lab11/embedded-gw/hardware/rev_c/embedded-gw_pcb.png

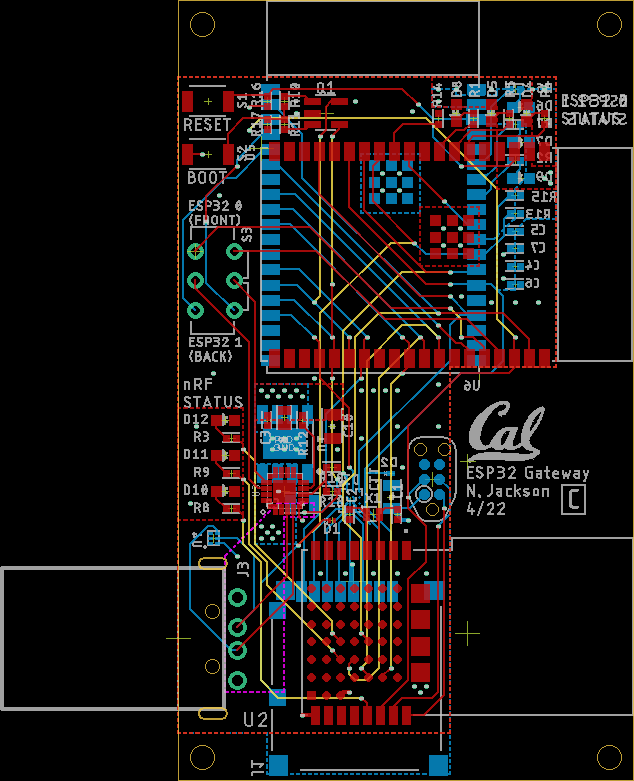
hardware/rev_c/embedded-gw_pcb.png
