lab11/embedded-gw/case/Case.stl

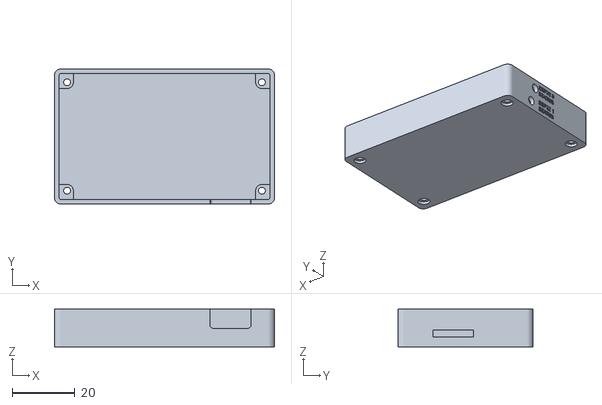
[picture p2: CAD file, 2022-06-08]
case/Case.stl
70.0 x 43.0 x 12.0
