lab11/embedded-gw/case/Top.stl

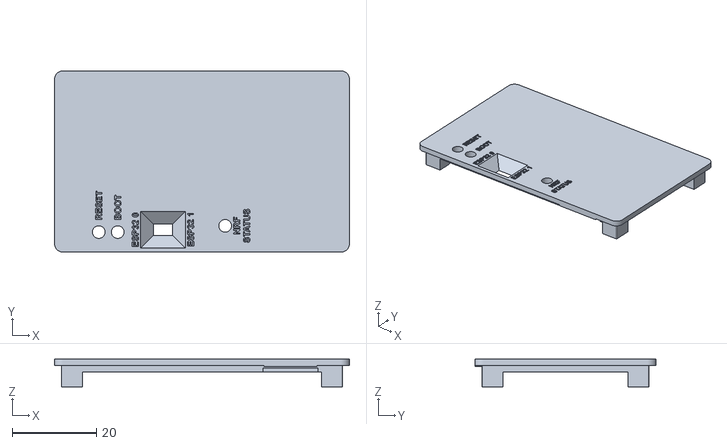
[picture p3: CAD file, 2022-06-08]
case/Top.stl
70.0 x 43.0 x 6.57
