lab11/embedded-gw/case/embedded_gw_enclosure v12.step

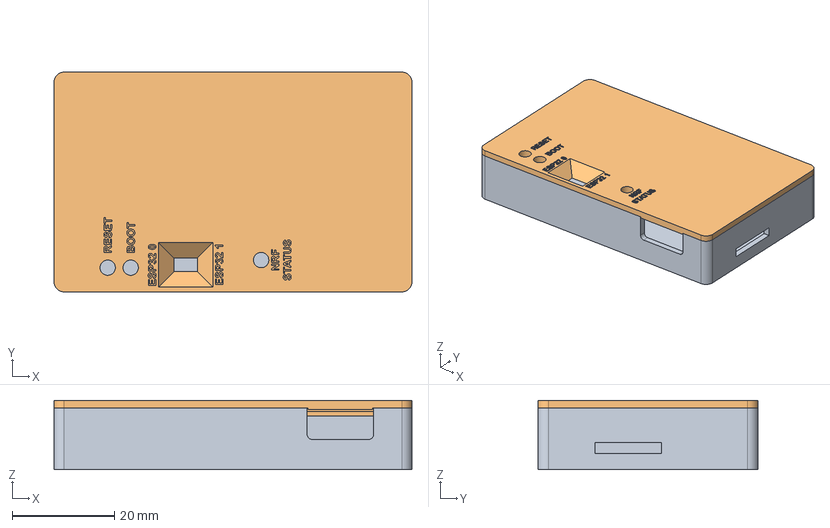
[picture p4: CAD file, 2022-06-08]
case/embedded_gw_enclosure v12.step
70.0 x 43.0 x 13.5 mm
Case
Top
