lab11/embedded-gw/(list of files, cad)

Other CAD files:
case/embedded_gw_enclosure v12.f3z
