lab11/embedded-gw/hardware/rev_c/embedded-gw.pdf

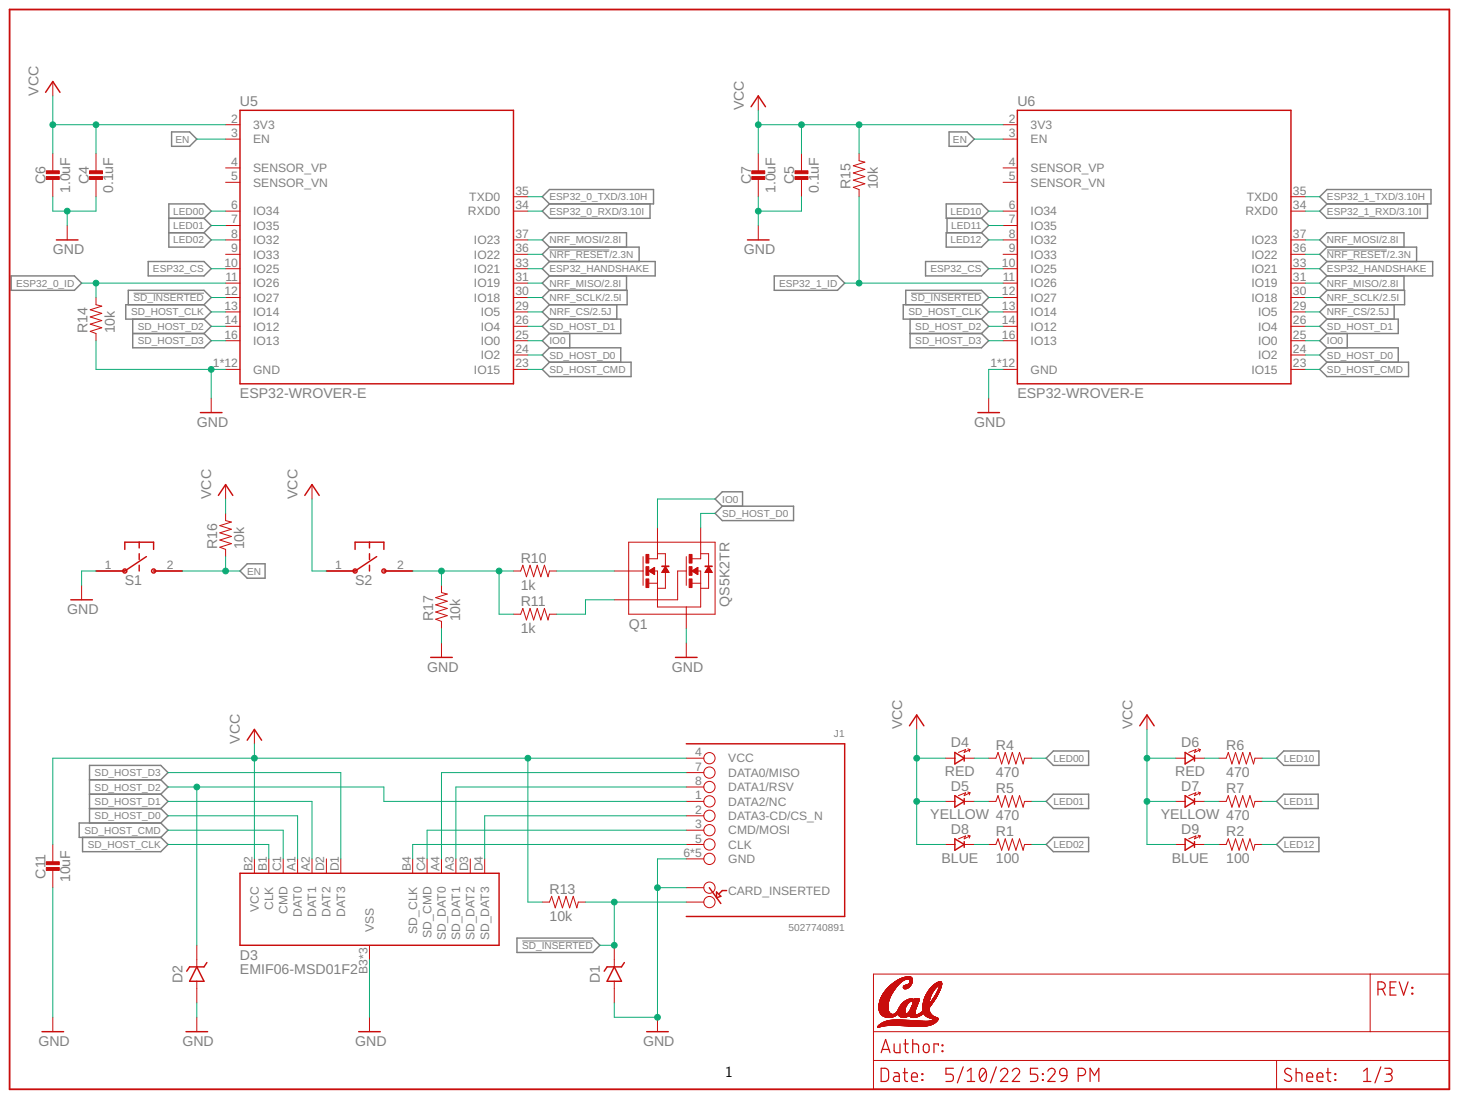
[picture p5: page 1]

6*5

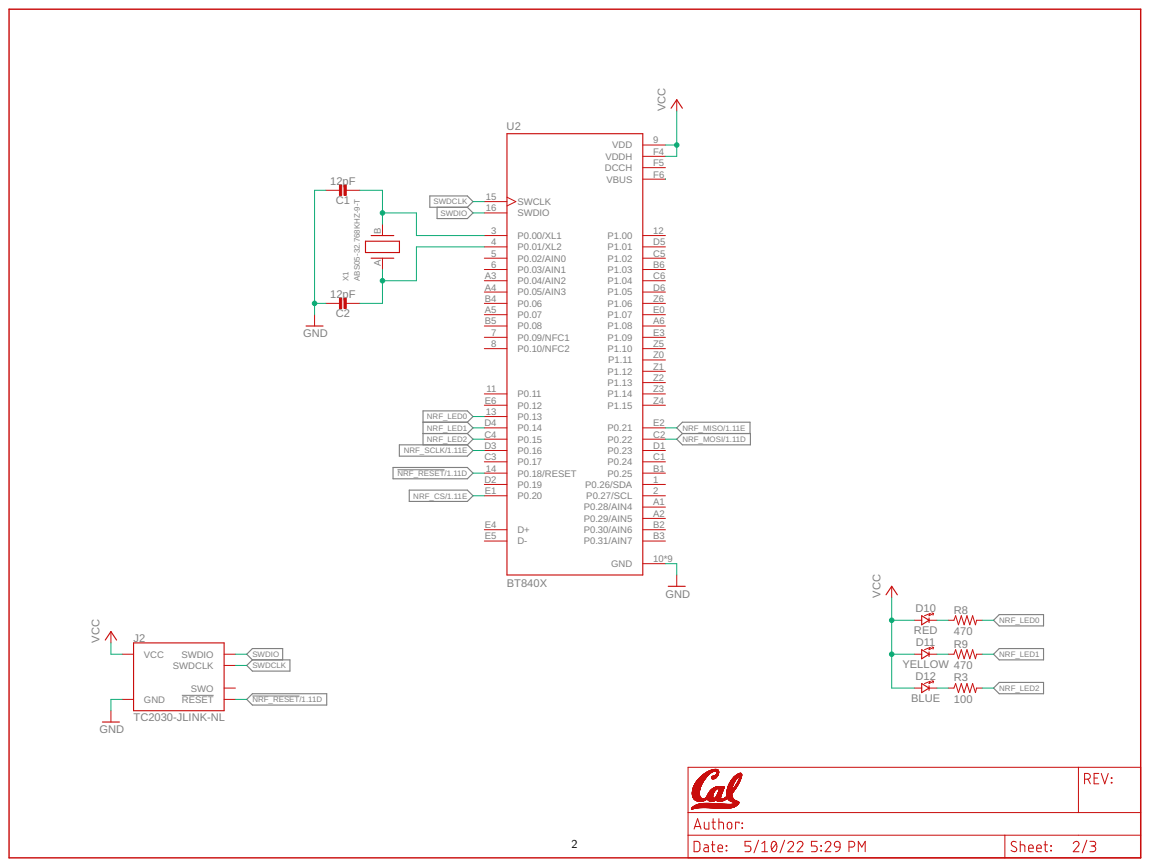
[picture p6: page 2]

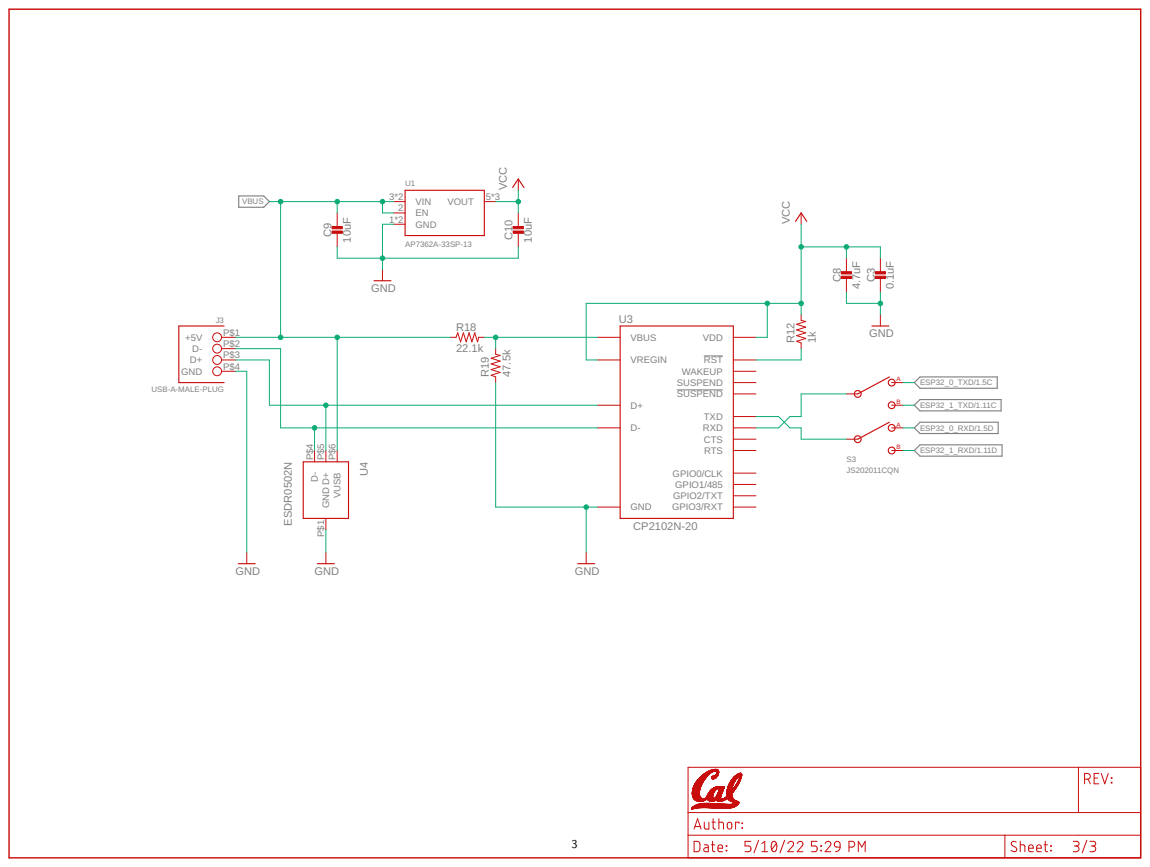
[picture p7: page 3]
CP2102N-20 USB-A-MALE-PLUG; JS202011CQN VCC GND; GND U⁴ ESDR⁰⁵⁰²N; GND; 0.1uF GND GND; VCC 10uF; 1k 47.5k22.1k VIN 3*2; VOUT; 5*3 GND 1*2; GND D- D+VBUS VREGIN; RST TXD RXD CTS RTS GPIO0/CLK GPIO1/485 WAKEUP SUSPEND SUSPEND VDD GPIO2/TXT GPIO3/RXT U3 +5V; P$3 GND; S3 VUSB P$6 D⁺ P$5 D⁻ P$4 GND P$1; C¹⁰; R¹² R¹⁹ R18; ESP32_0_TXD/1.5C ESP32_1_TXD/1.11C ESP32_0_RXD/1.5D ESP32_1_RXD/1.11D VBUS; ABAB

### Top and Bottom Layers

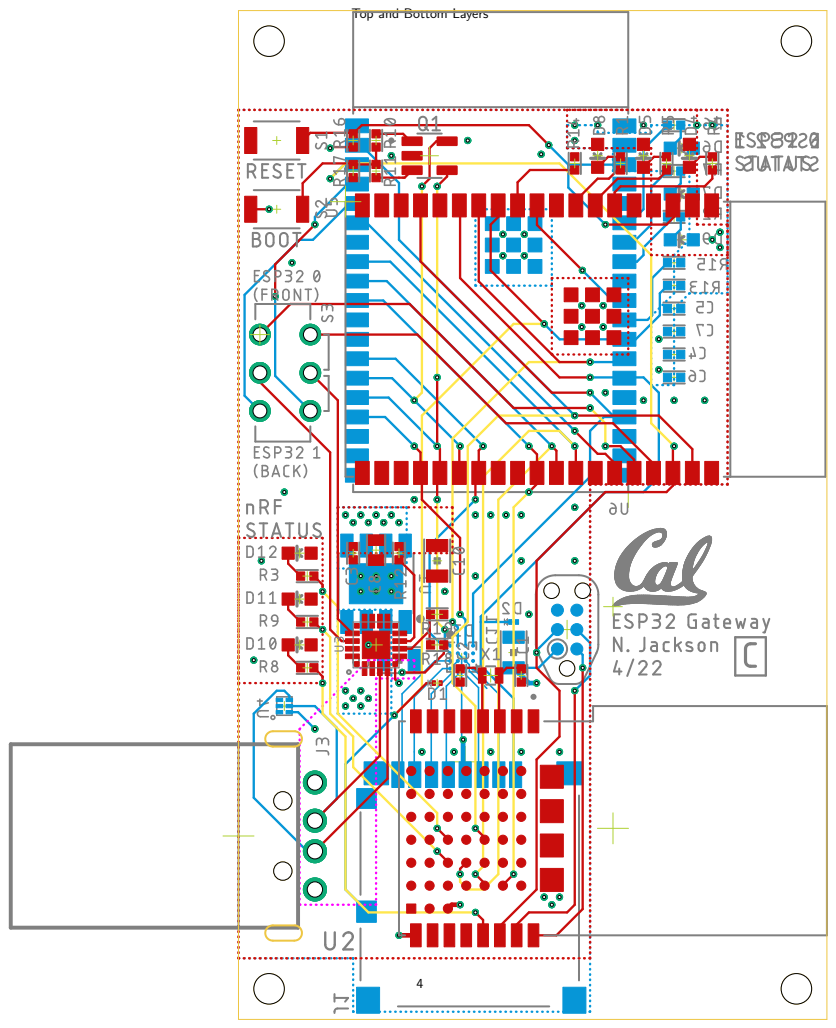
[picture p8: page 4]

### Top Layer

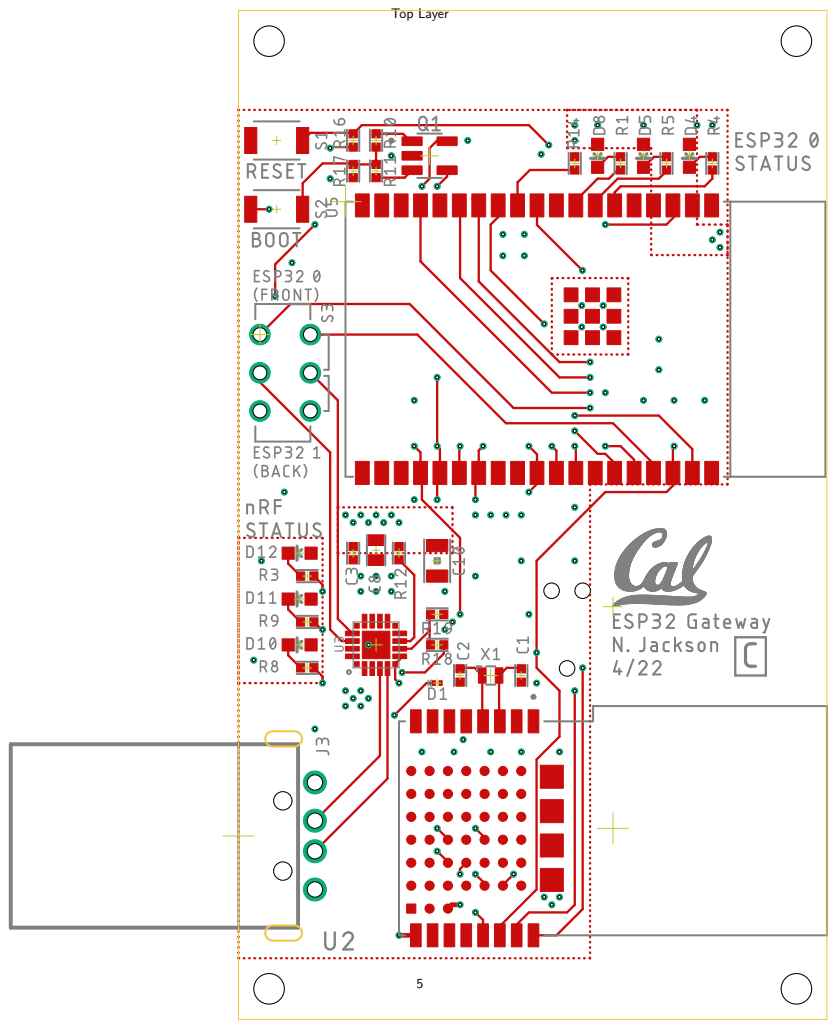
[picture p9: page 5]

### Bottom Layer

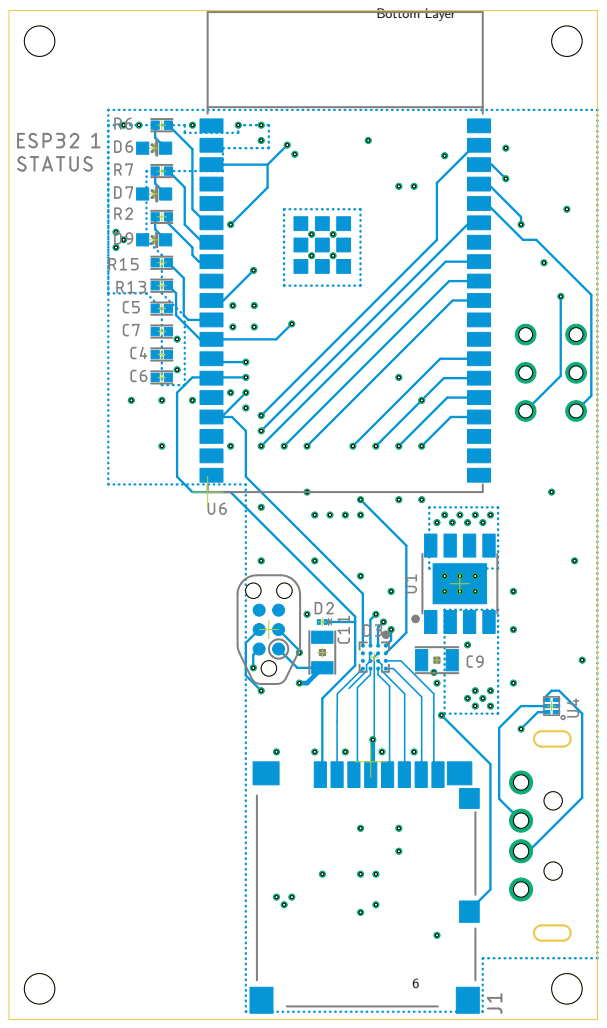
[picture p10: page 6]

### Top Copper Layer

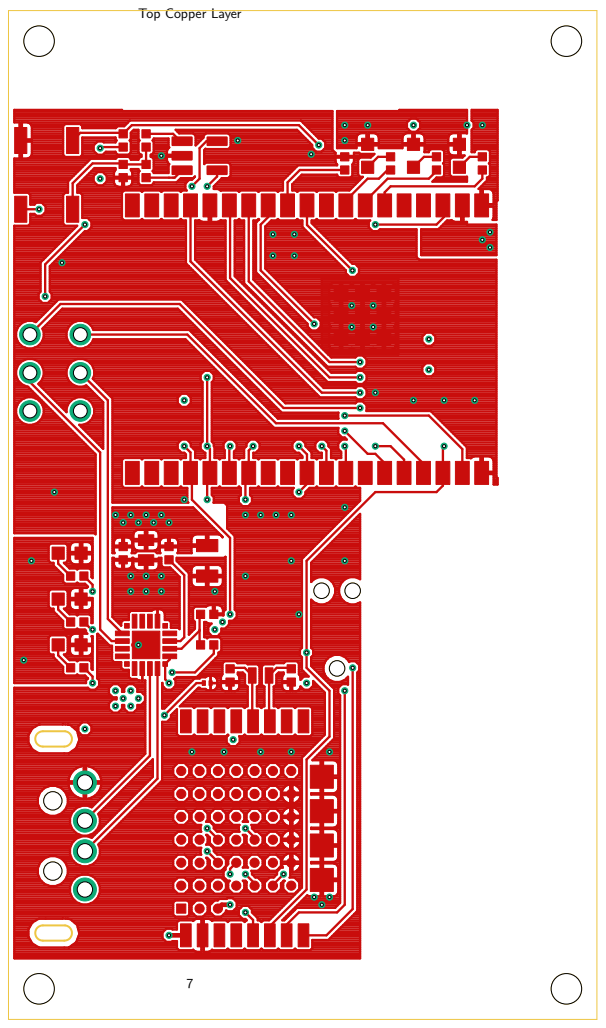
[picture p11: page 7]

### Layer 2 Copper

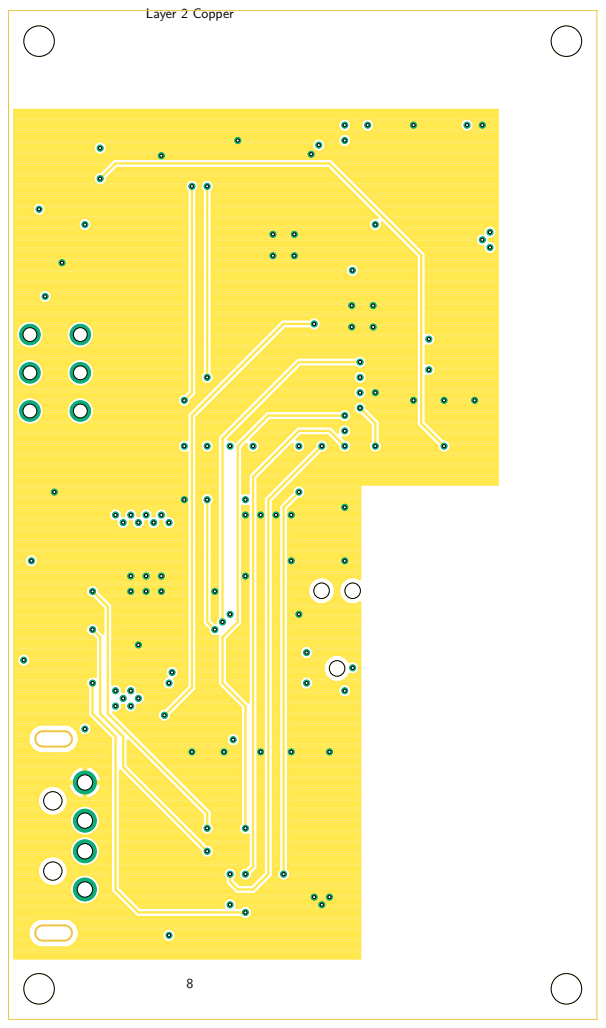
[picture p12: page 8]

### Layer 3 Copper

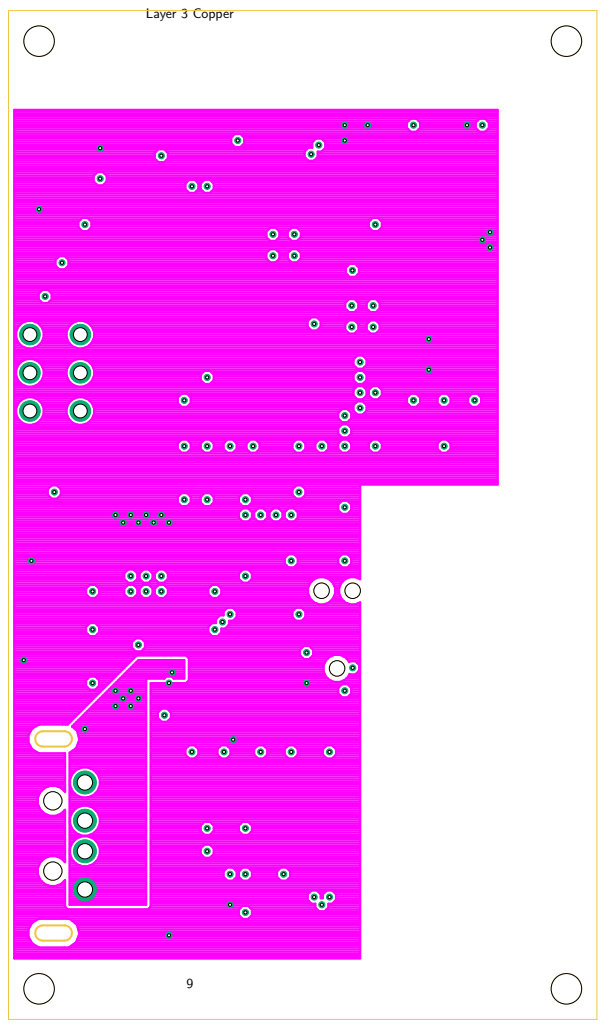
[picture p13: page 9]

### Bottom Copper Layer

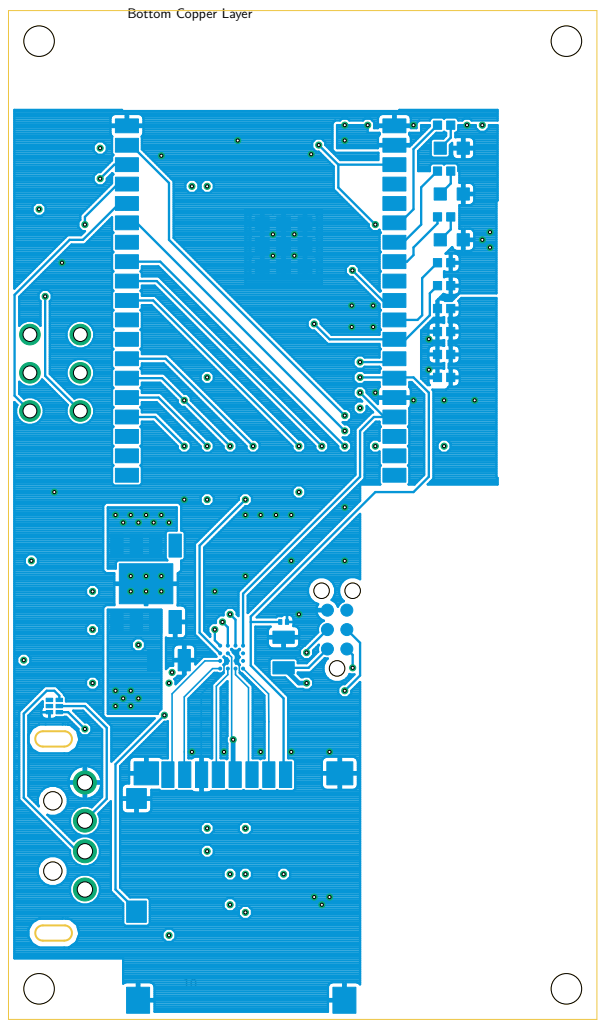
[picture p14: page 10]

### Top Paste Layer with Silkscreen

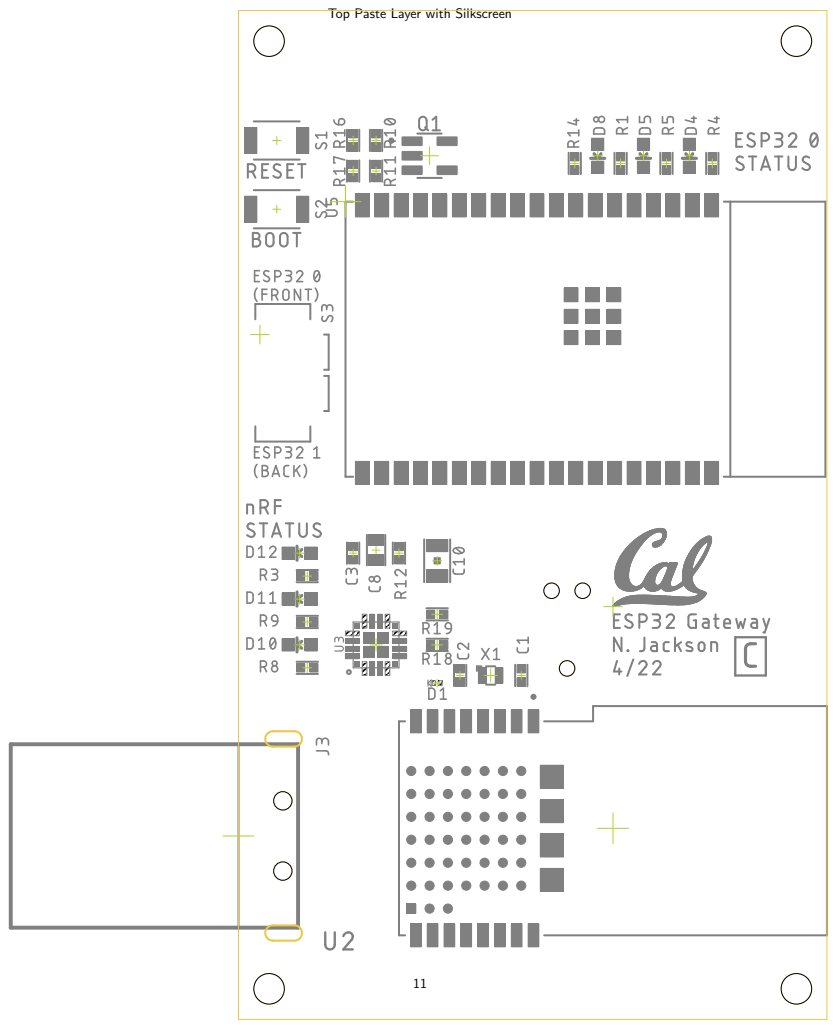
[picture p15: page 11]

### Bottom Paste Layer with Silkscreen

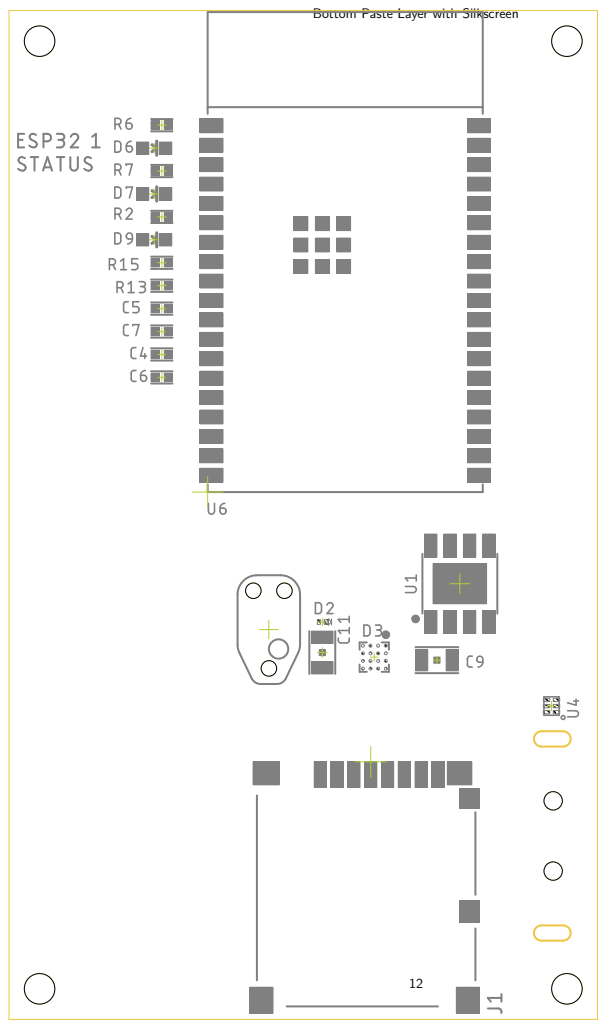
[picture p16: page 12]

### Top and Bottom Layers 1:1 Scale

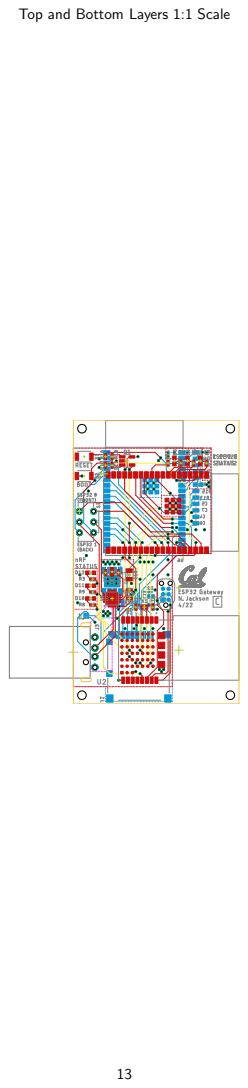
[picture p17: page 13]

### Top Layer 1:1 Scale

### Layer 2 Copper 1:1 Scale

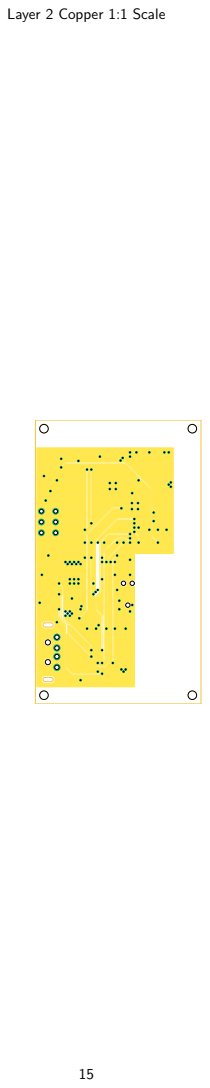
[picture p18: page 15]

### Layer 3 Copper 1:1 Scale

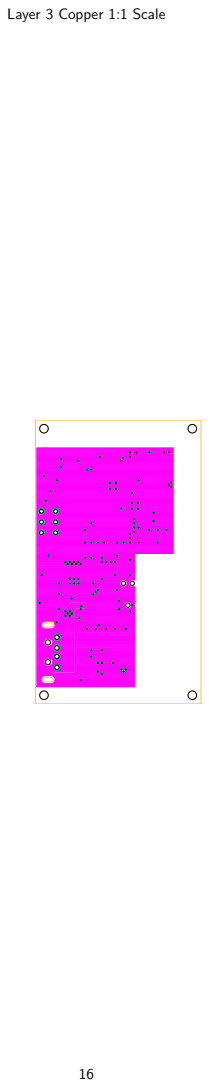
[picture p19: page 16]

### Bottom Copper Layer 1:1 Scale

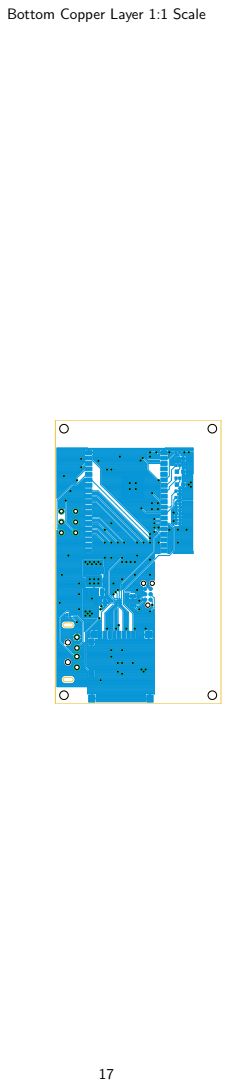
[picture p20: page 17]
