lab11/embedded-gw/hardware/rev_c/embedded-gw.brd

## EAGLE design hardware/rev_c/embedded-gw.brd (2022-05-11)

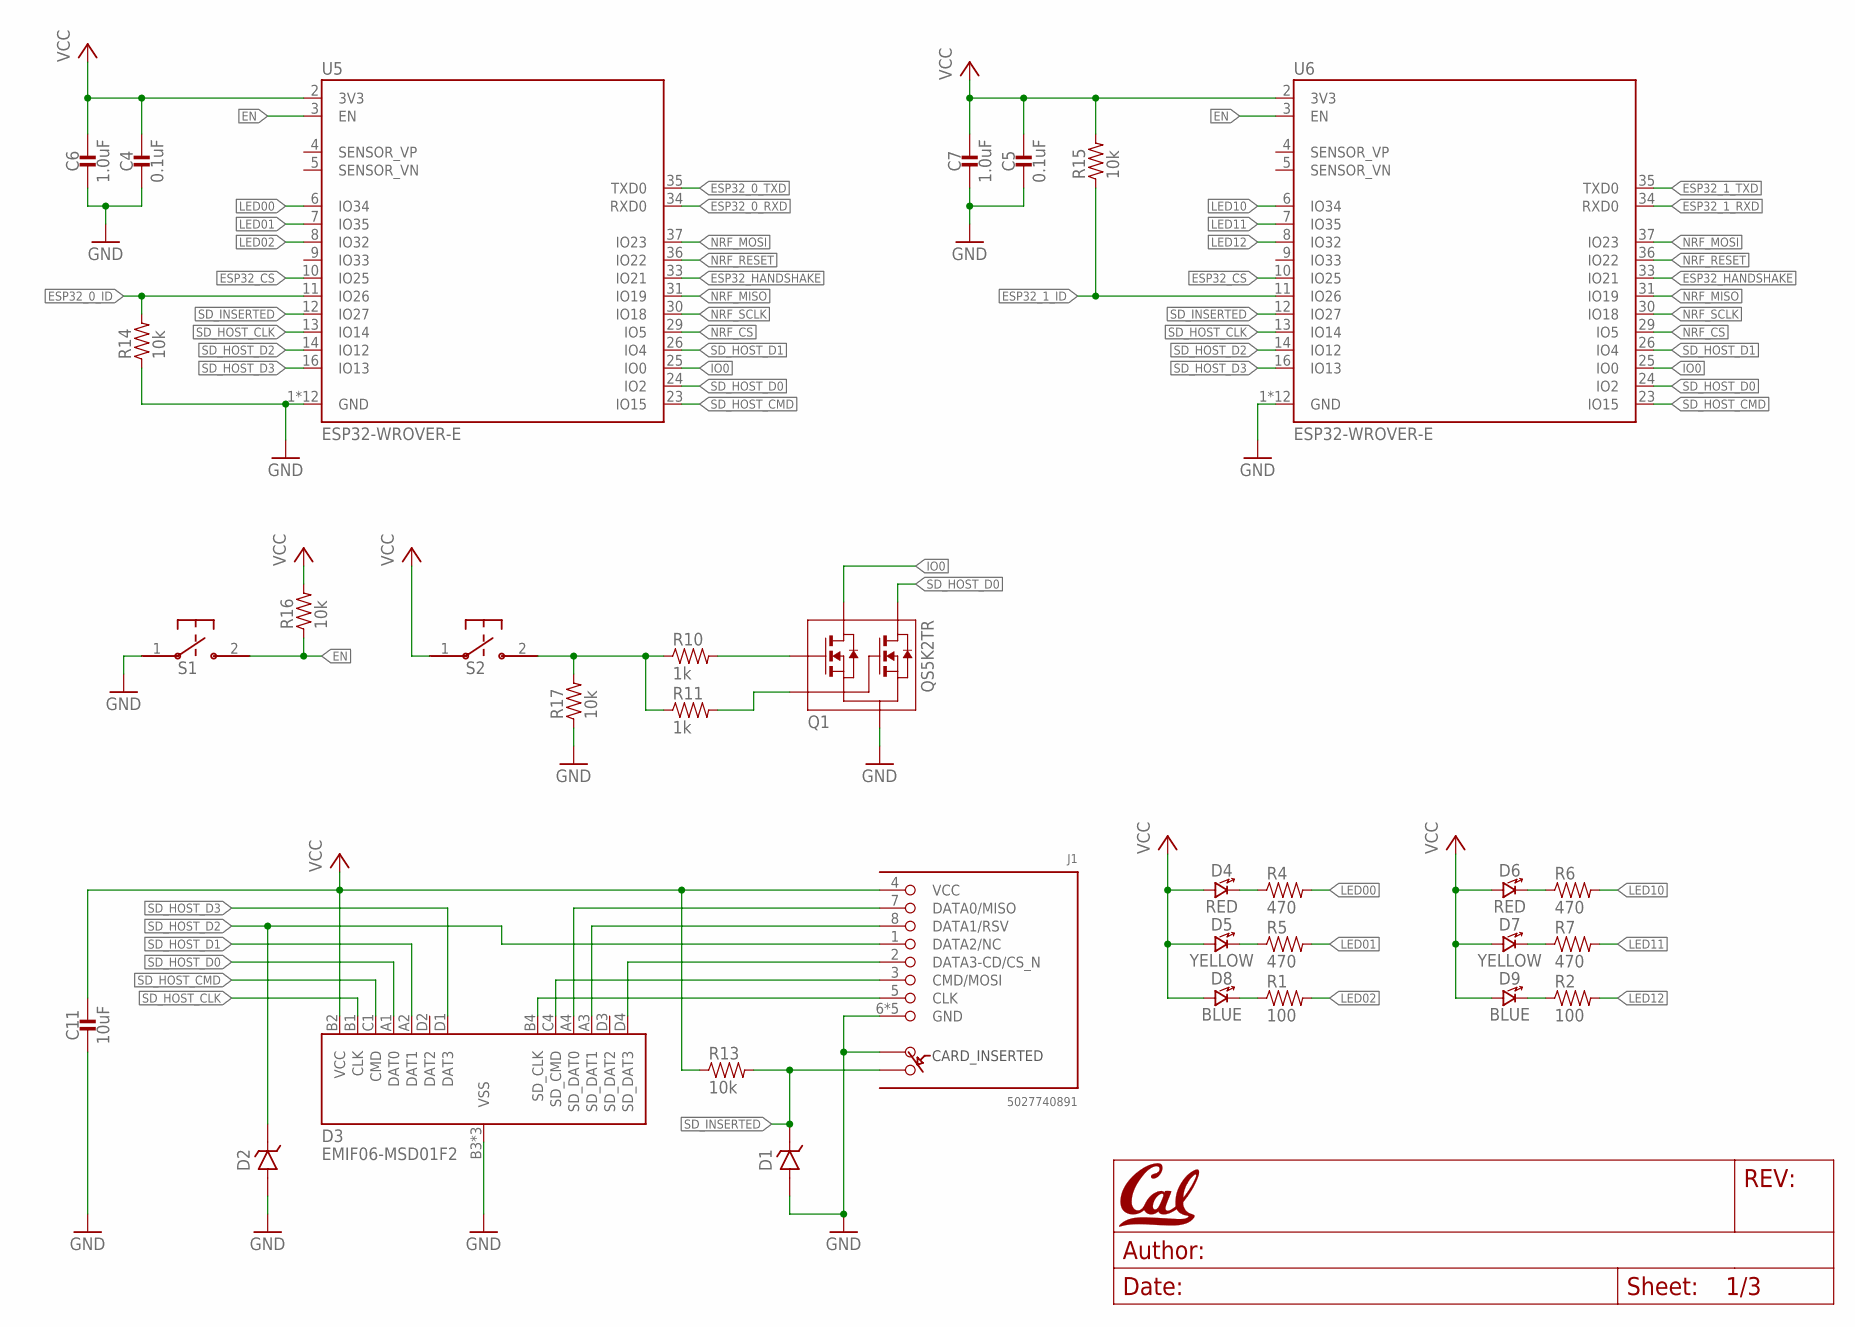
[picture p53: schematic embedded-gw.sch, sheet 1]

Parts:
C4, C5: 0.1uF; 0402_CAP; MPN CL05B104KQ5NNNC; DIGIKEY 1276-1511-1-ND
C6, C7: 1.0uF; 0402_CAP; MPN CL05A105KQ5NNNC; DIGIKEY 1276-1010-1-ND
C11: 10uF; 0805_CAP; MPN CL21A106KQCLNNC; DIGIKEY 1276-2404-1-ND
D1, D2: DIODE_ZENER0201; 0201_DIODE; MPN ESD7381MUT5G; DIGIKEY ESD7381MUT5GOSCT-ND
D3: EMIF06-MSD01F2; BGA16C50P4X4_192X192X65N
D4, D6: RED; LED-0603; MPN LTST-C193KRKT-5A; DIGIKEY 160-1830-1-ND
D5, D7: YELLOW; LED-0603; MPN LTST-C193KSKT-5A; DIGIKEY 160-1831-1-ND
D8, D9: BLUE; LED-0603; MPN LTST-C193TBKT-5A; DIGIKEY 160-1827-1-ND
J1: 5027740891
Q1: QS5K2TR; SOT95P280X100-5N
R1, R2: 100; 0402_RES; MPN RC0402JR-07100RL; DIGIKEY 311-100JRCT-ND
R4, R5, R6, R7: 470; 0402_RES; MPN RC0402FR-07470RL; DIGIKEY 311-470LRCT-ND
R10, R11: 1k; 0402_RES; MPN RMCF0402JT1K00; DIGIKEY RMCF0402JT1K00CT-ND
R13, R14, R15, R16, R17: 10k; 0402_RES; MPN RMCF0402JT10K0; DIGIKEY RMCF0402JT10K0CT-ND
S1, S2: B3U-1000P
U5, U6: ESP32-WROVER-E

Connections:
!NRF_RESET: U5.36 (IO22), U6.36 (IO22); also elsewhere on the board
!SD_INSERTED: D1.P$1 (CATHODE), J1.SWITCH (B), R13.2, U5.12 (IO27), U6.12 (IO27)
EN: R16.1, S1.2, U5.3 (EN), U6.3 (EN)
ESP32_0_ID: R14.2, U5.11 (IO26)
ESP32_0_RXD: U5.34 (RXD0); also elsewhere on the board
ESP32_0_TXD: U5.35 (TXD0); also elsewhere on the board
ESP32_1_ID: R15.1, U6.11 (IO26)
ESP32_1_RXD: U6.34 (RXD0); also elsewhere on the board
ESP32_1_TXD: U6.35 (TXD0); also elsewhere on the board
ESP32_CS: U5.10 (IO25), U6.10 (IO25)
ESP32_HANDSHAKE: U5.33 (IO21), U6.33 (IO21)
GND: C4.2, C5.2, C6.2, C7.2, C11.P$2 (2), D1.P$2 (ANODE), D2.P$2 (ANODE), D3.B3 (VSS), D3.C2 (VSS), D3.C3 (VSS), J1.6 (GND), J1.DETECT (A), J1.GND1 (GND), J1.GND2 (GND), J1.GND3 (GND), J1.GND4 (GND), Q1.2 (S), R14.1, R17.1, S1.1, U5.1 (GND), U5.15 (GND), U5.38 (GND), U5.GND1 (GND), U5.GND2 (GND), U5.GND3 (GND), U5.GND4 (GND), U5.GND5 (GND), U5.GND6 (GND), U5.GND7 (GND), U5.GND8 (GND), U5.GND9 (GND), U6.1 (GND), U6.15 (GND), U6.38 (GND), U6.GND1 (GND), U6.GND2 (GND), U6.GND3 (GND), U6.GND4 (GND), U6.GND5 (GND), U6.GND6 (GND), U6.GND7 (GND), U6.GND8 (GND), U6.GND9 (GND); also elsewhere on the board
IO0: Q1.5 (D1), U5.25 (IO0), U6.25 (IO0)
LED00: R4.2, U5.6 (IO34)
LED01: R5.2, U5.7 (IO35)
LED02: R1.2, U5.8 (IO32)
LED10: R6.2, U6.6 (IO34)
LED11: R7.2, U6.7 (IO35)
LED12: R2.2, U6.8 (IO32)
unnamed: Q1.1 (G1), R10.2
unnamed: Q1.3 (G2), R11.2
unnamed: R10.1, R11.1, R17.2, S2.2
unnamed: D3.C4 (SD_CMD), J1.3 (CMD/MOSI)
unnamed: D3.A4 (SD_DAT0), J1.7 (DATA0/MISO)
unnamed: D3.A3 (SD_DAT1), J1.8 (DATA1/RSV)
unnamed: D3.D4 (SD_DAT3), J1.2 (DATA3-CD/CS_N)
unnamed: D4.C (CATHODE), R4.1
unnamed: D3.B4 (SD_CLK), J1.5 (CLK)
unnamed: D5.C (CATHODE), R5.1
unnamed: D8.C (CATHODE), R1.1
unnamed: D6.C (CATHODE), R6.1
unnamed: D7.C (CATHODE), R7.1
unnamed: D9.C (CATHODE), R2.1
NRF_CS: U5.29 (IO5), U6.29 (IO5); also elsewhere on the board
NRF_MISO: U5.31 (IO19), U6.31 (IO19); also elsewhere on the board
NRF_MOSI: U5.37 (IO23), U6.37 (IO23); also elsewhere on the board
NRF_SCLK: U5.30 (IO18), U6.30 (IO18); also elsewhere on the board
SD_HOST_CLK: D3.B1 (CLK), U5.13 (IO14), U6.13 (IO14)
SD_HOST_CMD: D3.C1 (CMD), U5.23 (IO15), U6.23 (IO15)
SD_HOST_D0: D3.A1 (DAT0), Q1.4 (D2), U5.24 (IO2), U6.24 (IO2)
SD_HOST_D1: D3.A2 (DAT1), U5.26 (IO4), U6.26 (IO4)
SD_HOST_D2: D2.P$1 (CATHODE), J1.1 (DATA2/NC), U5.14 (IO12), U6.14 (IO12)
SD_HOST_D3: D3.D1 (DAT3), U5.16 (IO13), U6.16 (IO13)
VCC: C4.1, C5.1, C6.1, C7.1, C11.P$1 (1), D3.B2 (VCC), D4.A (ANODE), D5.A (ANODE), D6.A (ANODE), D7.A (ANODE), D8.A (ANODE), D9.A (ANODE), J1.4 (VCC), R13.1, R15.2, R16.2, S2.1, U5.2 (3V3), U6.2 (3V3); also elsewhere on the board

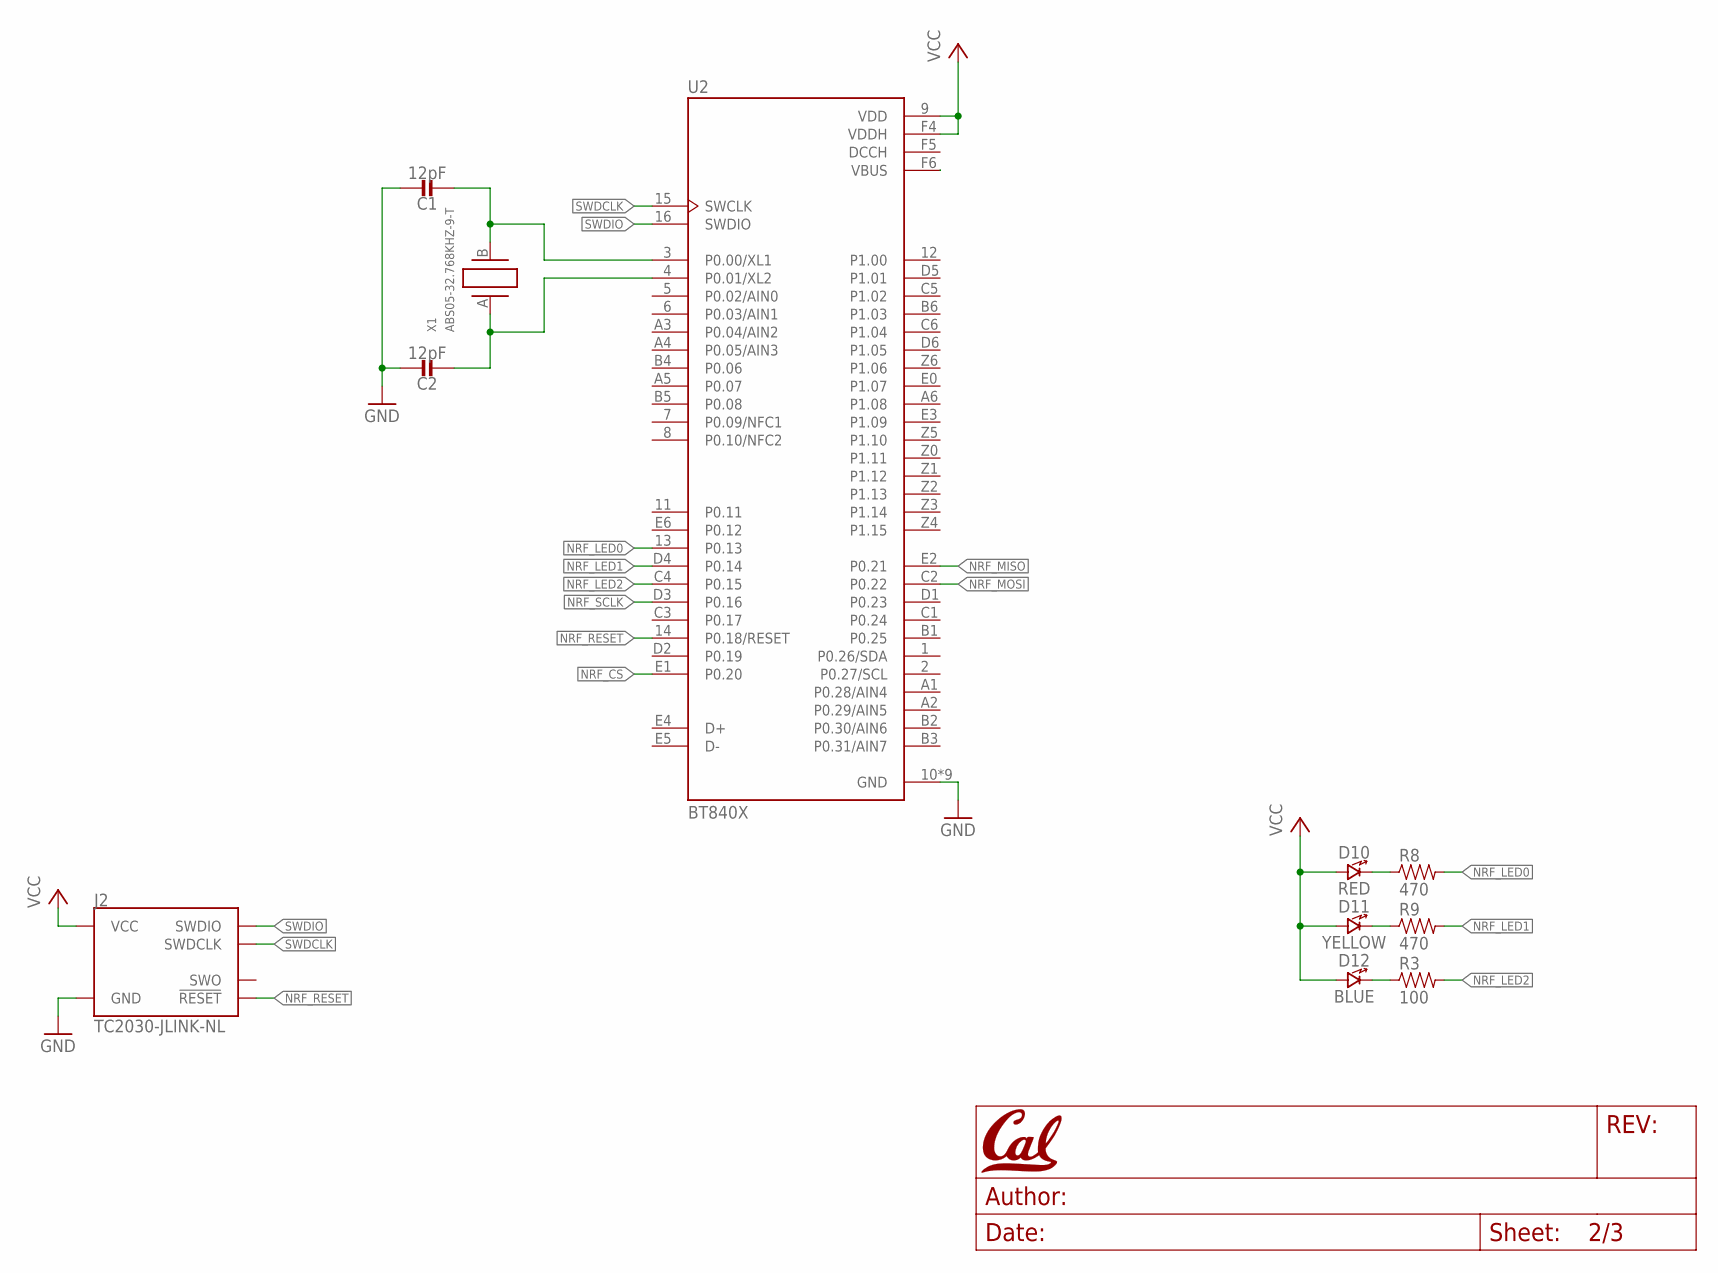
[picture p54: schematic embedded-gw.sch, sheet 2]

Parts:
C1, C2: 12pF; 0402_CAP; MPN GCM1555C1H120GA16D; DIGIKEY 490-GCM1555C1H120GA16DCT-ND
D10: RED; LED-0603; MPN LTST-C193KRKT-5A; DIGIKEY 160-1830-1-ND
D11: YELLOW; LED-0603; MPN LTST-C193KSKT-5A; DIGIKEY 160-1831-1-ND
D12: BLUE; LED-0603; MPN LTST-C193TBKT-5A; DIGIKEY 160-1827-1-ND
J2: TC2030-JLINK-NL; TC2030-IDC-NL
R3: 100; 0402_RES; MPN RC0402JR-07100RL; DIGIKEY 311-100JRCT-ND
R8, R9: 470; 0402_RES; MPN RC0402FR-07470RL; DIGIKEY 311-470LRCT-ND
U2: BT840X; XCVR_BT840X
X1: ABS05-32.768KHZ-9-T; ABS05

Connections:
!NRF_RESET: J2.3 (!RESET), U2.14 (P0.18/RESET); also elsewhere on the board
DCCH: U2.F5 (DCCH)
GND: C1.1, C2.1, J2.5 (GND), U2.10 (GND), U2.A0 (GND), U2.B0 (GND), U2.C0 (GND), U2.D0 (GND), U2.F0 (GND), U2.F1 (GND), U2.F2 (GND), U2.F3 (GND); also elsewhere on the board
unnamed: C1.2, U2.3 (P0.00/XL1), X1.B (2)
unnamed: C2.2, U2.4 (P0.01/XL2), X1.A (1)
unnamed: D10.C (CATHODE), R8.1
unnamed: D11.C (CATHODE), R9.1
unnamed: D12.C (CATHODE), R3.1
NC: U2.F6 (VBUS)
NRF_CS: U2.E1 (P0.20); also elsewhere on the board
NRF_LED0: R8.2, U2.13 (P0.13)
NRF_LED1: R9.2, U2.D4 (P0.14)
NRF_LED2: R3.2, U2.C4 (P0.15)
NRF_MISO: U2.E2 (P0.21); also elsewhere on the board
NRF_MOSI: U2.C2 (P0.22); also elsewhere on the board
NRF_SCLK: U2.D3 (P0.16); also elsewhere on the board
SWDCLK: J2.4 (SWDCLK), U2.15 (SWCLK)
SWDIO: J2.2 (SWDIO), U2.16 (SWDIO)
VCC: D10.A (ANODE), D11.A (ANODE), D12.A (ANODE), J2.1 (VCC), U2.9 (VDD), U2.F4 (VDDH); also elsewhere on the board

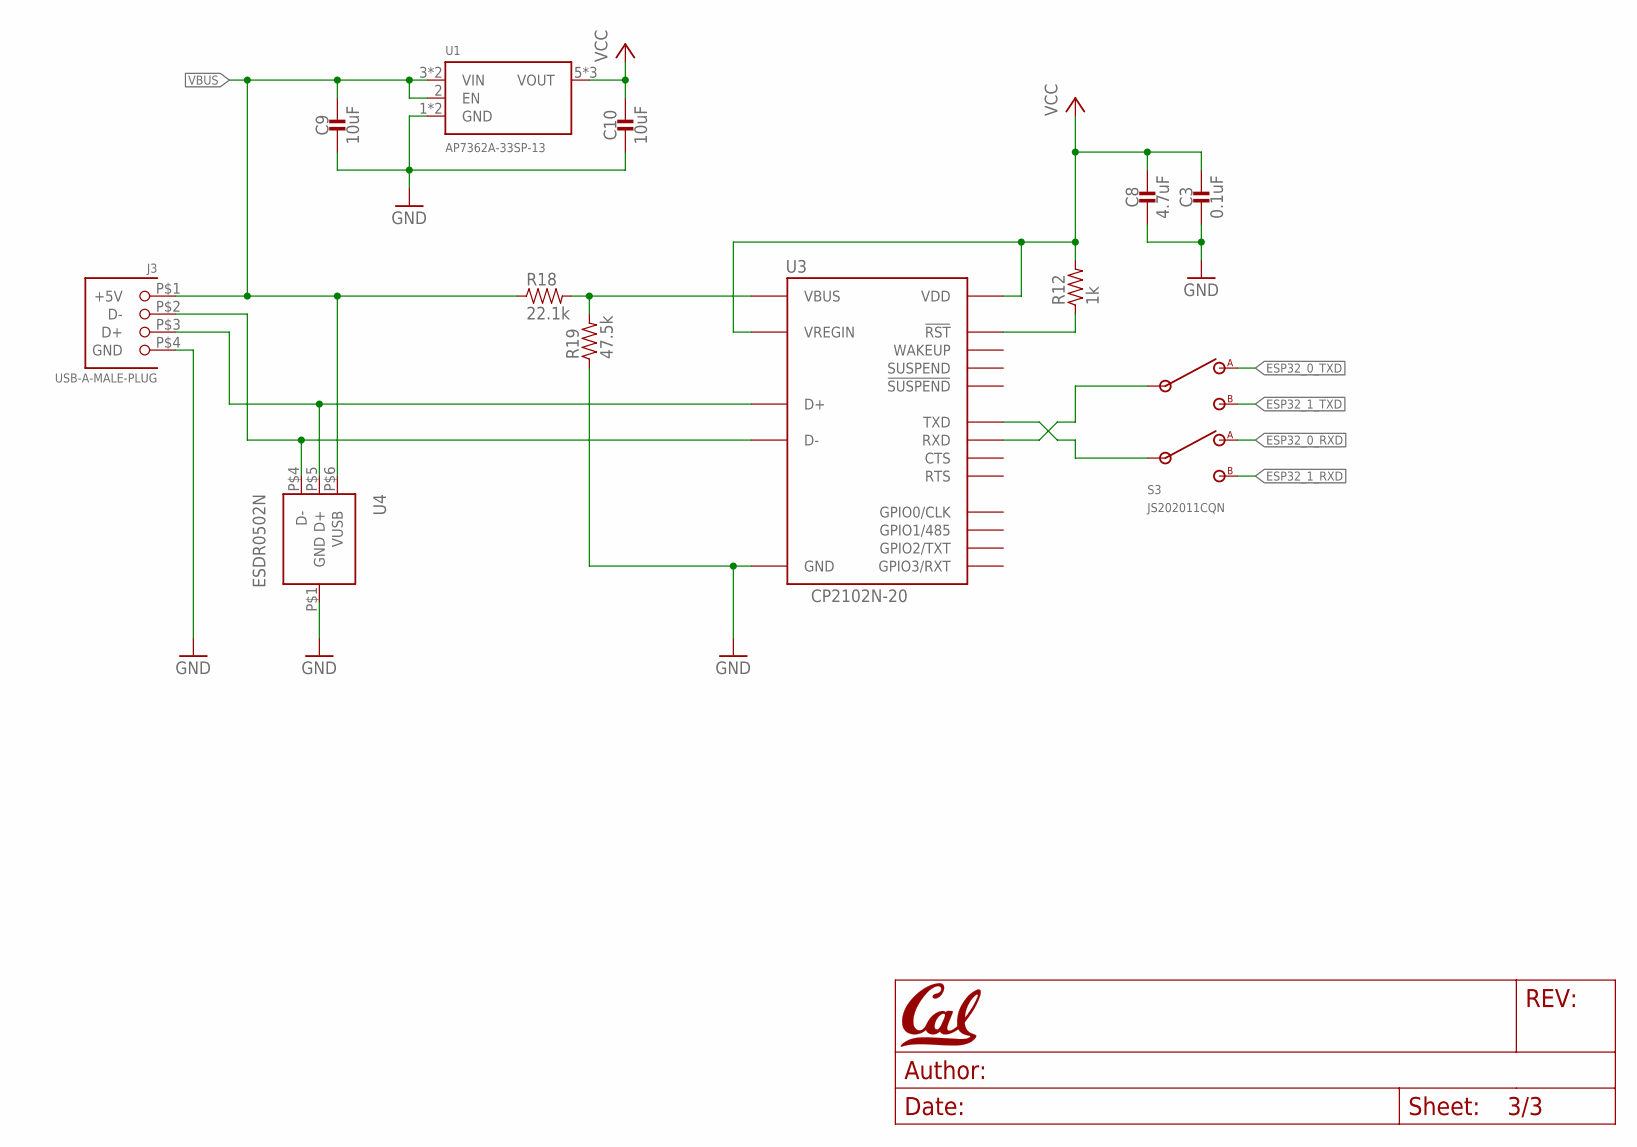
[picture p55: schematic embedded-gw.sch, sheet 3]

Parts:
C3: 0.1uF; 0402_CAP; MPN CL05B104KQ5NNNC; DIGIKEY 1276-1511-1-ND
C8: 4.7uF; 0603_CAP; MPN CL10A475KQ8NNNC; DIGIKEY 1276-1045-1-ND
C9, C10: 10uF; 0805_CAP; MPN CL21A106KQCLNNC; DIGIKEY 1276-2404-1-ND
J3: USB-A-MALE-PLUG; USB_A_MALE_PLUG_CUI_UP2-AH
R12: 1k; 0402_RES; MPN RMCF0402JT1K00; DIGIKEY RMCF0402JT1K00CT-ND
R18: 22.1k; 0402_RES; MPN RC0402FR-0722K1L; DIGIKEY 311-22.1KLRCT-ND
R19: 47.5k; 0402_RES; MPN RT0402FRE0747K5L; DIGIKEY 13-RT0402FRE0747K5LCT-ND
S3: JS202011CQN
U1: AP7362A-33SP-13; SO-8EP
U3: CP2102N-20; QFN-20-3MM
U4: ESDR0502N; UDFN-6

Connections:
D+: J3.P$3 (D+), U3.4 (D+), U4.P$5 (D+)
D-: J3.P$2 (D-), U3.5 (D-), U4.P$4 (D-)
ESP32_0_RXD: S3.1 (A2); also elsewhere on the board
ESP32_0_TXD: S3.4 (A1); also elsewhere on the board
ESP32_1_RXD: S3.3 (B2); also elsewhere on the board
ESP32_1_TXD: S3.6 (B1); also elsewhere on the board
GND: C3.2, C8.2, C9.P$2 (2), C10.P$2 (2), J3.P$4 (GND), R19.1, U1.1 (GND), U1.PAD (GND), U3.3 (GND), U3.12 (GND), U3.P$1 (GND), U4.P$1 (GND); also elsewhere on the board
unnamed: R12.1, U3.9 (!RST)
unnamed: R18.2, R19.2, U3.8 (VBUS)
RXD: S3.2 (I2), U3.18 (TXD)
TXD: S3.5 (I1), U3.17 (RXD)
VBUS: C9.P$1 (1), J3.P$1 (+5V), R18.1, U1.2 (EN), U1.3 (VIN), U1.4 (VIN), U4.P$6 (VUSB)
VCC: C3.1, C8.1, C10.P$1 (1), R12.2, U1.5 (VOUT), U1.6 (VOUT), U1.7 (VOUT), U3.6 (VDD), U3.7 (VREGIN); also elsewhere on the board

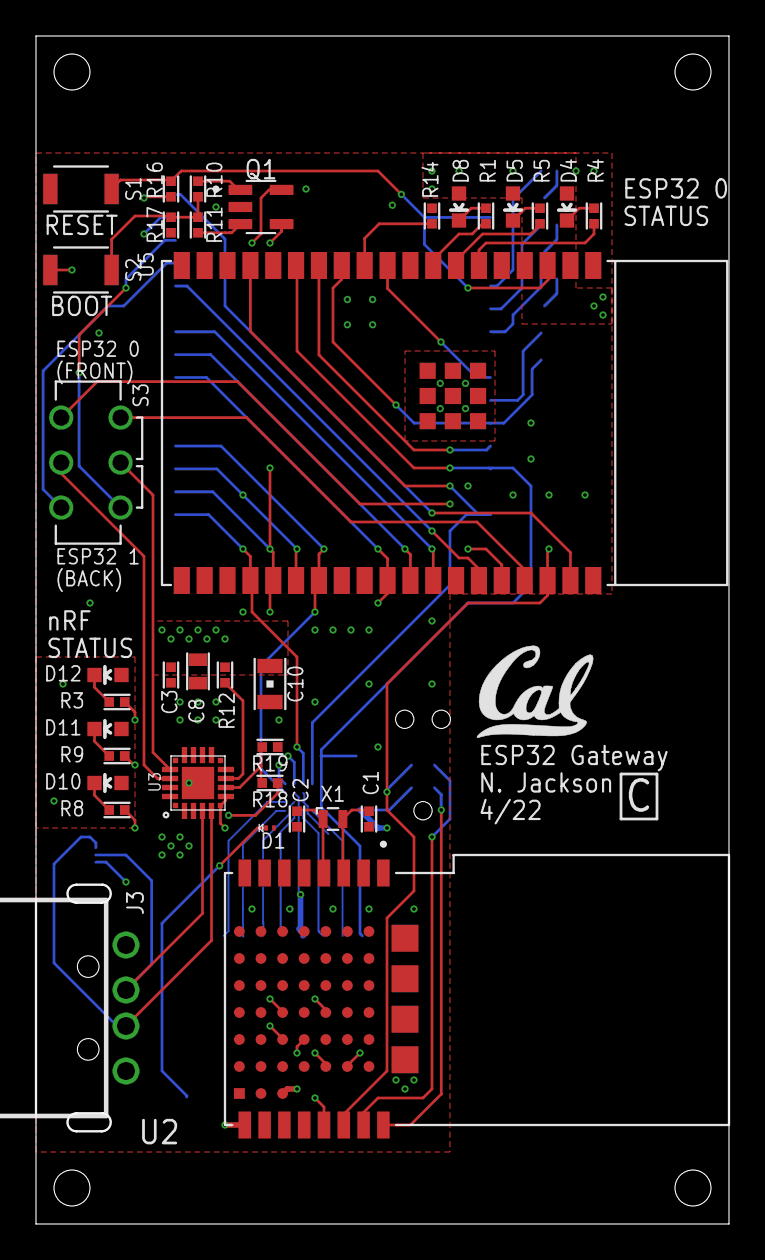
[picture p56: board embedded-gw.brd from above]

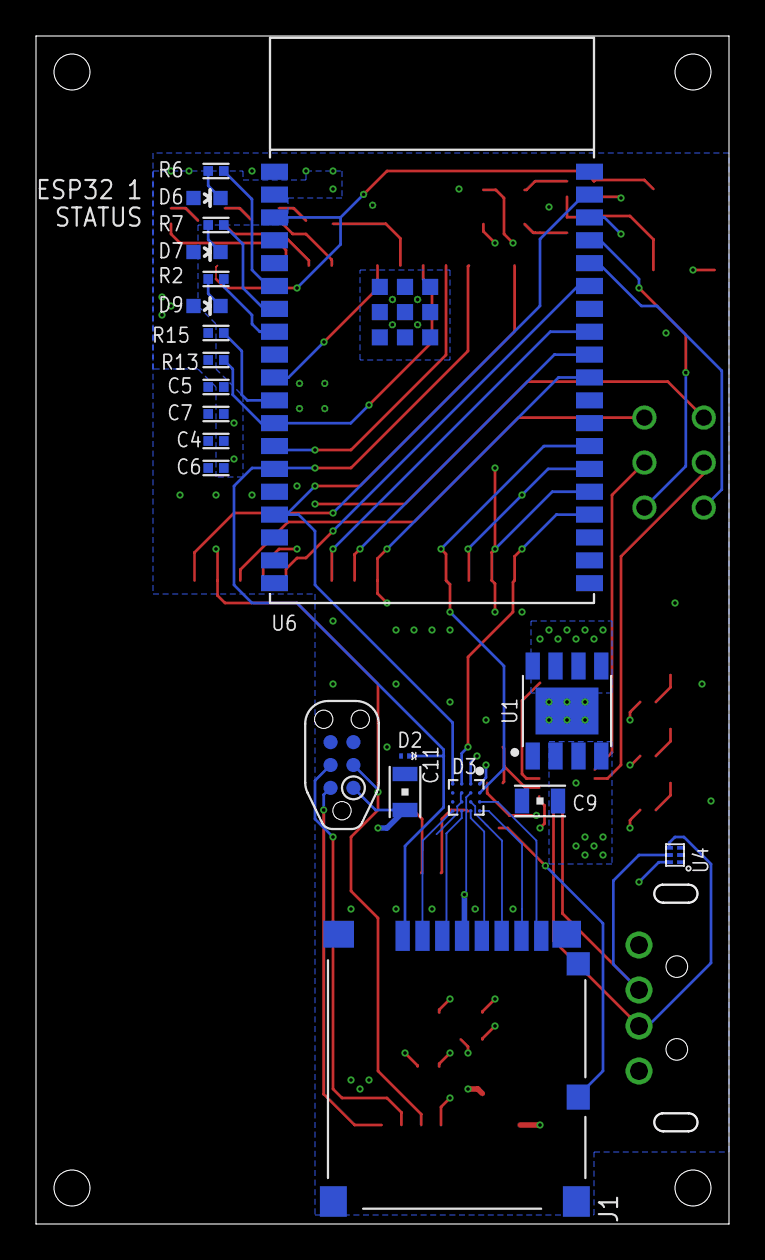
[picture p57: board embedded-gw.brd from below]

Board: 4 copper layers, 38.5 x 66.0 mm, 57 parts (21 on the bottom side), 61 nets.

Other parts of the board:
U$4: UCB_CAL_200MIL
