lab11/embedded-gw/(commit log)

2021-03-31 schematic done-ish
    [embedded-gw.brd, embedded-gw.sch]
2021-03-31 forgot to save
    [embedded-gw.brd, embedded-gw.sch]
2021-04-13 start layout
    [embedded-gw.brd, embedded-gw.sch]
2021-04-13 nothing to do
    [embedded-gw.brd]
2021-04-14 fix labels
    [embedded-gw.brd]
2021-04-15 Clean up and run the script
    rename parts, clean up bom, cam, package up
    [embedded-gw.brd, embedded-gw.sch, embedded-gw_bom.csv, embedded-gw_bom.xlsx]
2021-04-20 leave gpio12 floating, add diode
    [embedded-gw.brd, embedded-gw.sch, embedded-gw_bom.csv, embedded-gw_bom.xlsx]
2021-05-11 revb - disable bridge regulator
    [embedded-gw.brd, embedded-gw.sch, embedded-gw_bom.csv, embedded-gw_bom.xlsx]
2021-07-20 Change handshake gpio from 33 to 21, add ipc
    [embedded-gw.brd, embedded-gw.sch, embedded-gw_bom.csv, embedded-gw_bom.xlsx]
2021-07-20 update date to now
    [embedded-gw.brd]
2021-07-28 Swap Q1 with QS5K2TR
    [embedded-gw.brd, embedded-gw.sch, embedded-gw_bom.csv, embedded-gw_bom.xlsx]
2022-03-29 add mounting holes
    [embedded-gw.brd, embedded-gw.sch, embedded-gw_bom.csv, embedded-gw_bom.xlsx]
2022-03-30 Add fusion360 enclosure design
    [embedded_gw_enclosure v7.f3z]
2022-04-22 replace sd card slot
    [embedded-gw.brd, embedded-gw.sch, embedded-gw_bom.csv, embedded-gw_bom.xlsx]
2022-04-27 change sclk to pin 16 instead of PA 19
    [embedded-gw.brd, embedded-gw.sch]
2022-05-11 update BOM
    [embedded-gw.brd, embedded-gw.sch, embedded-gw_bom.csv, embedded-gw_bom.xlsx]
2022-05-16 add sd card slot + stl files
    [Case.stl, Top.stl, embedded_gw_enclosure v10.f3z, embedded_gw_enclosure v7.f3z]
2022-06-08 update screw socket in case top
    [Case.stl, Top.stl, embedded_gw_enclosure v10.f3z, embedded_gw_enclosure v12.f3z, embedded_gw_enclosure v12.step]
